Mirza-Asif/AT-PIC/3D Models/Array Holders/README.txt

This document logs changes made to 3D models. 
As a general rule of thumb, a new revision marks a new function or major geometric change to the design.
Sub-revisions (ex. REV1-2 vs REV1-3) are minor changes usually made for quality of life purposes or minor alterations like 3D printing tolerence adjustments.
A revision or sub-revision marked with *** means that it has not been tested yet. 
- B

REV1&2:
	Description:
		Non-funcitonal placeholders for demonstration
	Flaws:
		Just all of it.

REV3: 
	Description:
		A fiber holder based off of the one used on the MLP testbench.
	Flaws:
		Screw holes were too small and mirza wanted some alterations to the dimentions
REV4:
	Description:
		New adjusted model with more screw holes and changed dimentions. 
		Full set printed.
