Mirza-Asif/AT-PIC/3D Models/Foam Holders/README.txt

These guys are just little connecters to snap onto insulating foam so that you can tape it to a wall. 
Are they overengineered? yes.
Do they double as fun little fidget toys to have around the latb? Also yes.
- B

REV1: 
	Description:
		Initial design with a spinning top.
	Flaws:
		Way to big and takes FOREVER to print.
REV2: 
	Description:
		Made it a bit smaller. Also refined the locking mechanism.
	Flaws:
		These things break just while assembling them.
REV3:
	Description:
		Reinforced the weak parts and made them taller to better fit the foam thinkness.
	Flaws:
		Not nearly as fun to fidget with.
