Mirza-Asif/AT-PIC/3D Models/Z Arm/README.txt

These guys are just little connecters to snap onto insulating foam so that you can tape it to a wall. 
Are they overengineered? yes.
Do they double as fun little fidget toys to have around the latb? Also yes.
- B

REV1: 
	Description:
		So stupid I didnt even bother saving it.
	Flaws:
		Yes.
REV2: 
	Description:
		Fixed and tuned most of the issues. Its largely just the Z axis arm but with a vertical mount.
	Flaws: 
		Not really a flaw in the design, but this thing just wont print wihtout warping >:(
