Mirza-Asif/AT-PIC/Documentation/Senior Design Documents/Year 1 (2023-2024)/Semester 2 Timeline (Rev 3).xlsx

Sheet: GanttChart
AT-PIC Semester 2 - Timeline
 | Project Start Date: |  | 2024-01-15 |  |  |  | Week 0 |  |  |  |  |  |  | Week 1 |  |  |  |  |  |  | Week 2 |  |  |  |  |  |  | Week 3 |  |  |  |  |  |  | Week 4 |  |  |  |  |  |  | Week 5 |  |  |  |  |  |  | Week 6 |  |  |  |  |  |  | Week 7
 | Project Manager: |  | Mahdi Nikdast |  |  |  | 2024-01-08 |  |  |  |  |  |  | 2024-01-15 |  |  |  |  |  |  | 2024-01-22 |  |  |  |  |  |  | 2024-01-29 |  |  |  |  |  |  | 2024-02-05 |  |  |  |  |  |  | 2024-02-12 |  |  |  |  |  |  | 2024-02-19 |  |  |  |  |  |  | 2024-02-26
 |  |  |  |  |  |  | 2024-01-08 | 2024-01-09 | 2024-01-10 | 2024-01-11 | 2024-01-12 | 2024-01-13 | 2024-01-14 | 2024-01-15 | 2024-01-16 | 2024-01-17 | 2024-01-18 | 2024-01-19 | 2024-01-20 | 2024-01-21 | 2024-01-22 | 2024-01-23 | 2024-01-24 | 2024-01-25 | 2024-01-26 | 2024-01-27 | 2024-01-28 | 2024-01-29 | 2024-01-30 | 2024-01-31 | 2024-02-01 | 2024-02-02 | 2024-02-03 | 2024-02-04 | 2024-02-05 | 2024-02-06 | 2024-02-07 | 2024-02-08 | 2024-02-09 | 2024-02-10 | 2024-02-11 | 2024-02-12 | 2024-02-13 | 2024-02-14 | 2024-02-15 | 2024-02-16 | 2024-02-17 | 2024-02-18 | 2024-02-19 | 2024-02-20 | 2024-02-21 | 2024-02-22 | 2024-02-23 | 2024-02-24 | 2024-02-25 | 2024-02-26 | 2024-02-27 | 2024-02-28
WBS | Task | Task | Start | End | % Done | Work Days | M | T | W | Th | F | Sa | Su | M | T | W | Th | F | Sa | Su | M | T | W | Th | F | Sa | Su | M | T | W | Th | F | Sa | Su | M | T | W | Th | F | Sa | Su | M | T | W | Th | F | Sa | Su | M | T | W | Th | F | Sa | Su | M | T | W
1 | [ Task Category ] | [Name] | 2024-01-16 | 2024-05-06 | 100% | 80
1.1 | Ali | Learn LabVIEW | 2024-01-18 | 2024-02-18 | 100% | 22
1.2 | Gavin | Power Supply Setup for Aerotech | 2024-01-18 | 2024-02-27 | 100% | 29
1.3 | Trent | Interface With Newport Controllers | 2024-01-24 | 2024-02-28 | 95% | 26
1.4 | Ben | Design Hexapod Arm | 2024-02-12 | 2024-02-25 | 100% | 10
1.5 | Ben | Manufacture Hexapod Arm | 2024-02-25 | 2024-03-02 | 100% | 5
1.6 | Gavin | Power System Setup for SMCI | 2024-02-27 | 2024-03-12 | 100% | 11
1.7 | Ali | Interface with controllers using labview | 2024-03-01 | 2024-04-01 | 50% | 22
1.9 | Ben | Design Z axis Arm | 2024-03-04 | 2024-03-11 | 100% | 7
1.9 | Ben | Manufacture Z axis Arm | 2024-03-11 | 2024-03-15 | 100% | 7
1.10 | Ben | Design Base for Mounting | 2024-03-11 | 2024-03-26 | 100% | 12
1.11 | Ben | Manufacture Base for Mounting | 2024-03-20 | 2024-03-30 | 100% | 8
1.12 | Trent | Automating Hexapod | 2024-03-26 | 2024-04-04 | 50% | 8
1.13 | Gavin | Mounting/Wiring | 2024-03-26 | 2024-04-04 | 100% | 8
1.14 | All | All Physical Components Done | 2024-04-04 | 2024-04-12 | 100% | 7

Sheet: Help
Help |  | © 2012-2018 Vertex42 LLC
 |  | Contact Vertex42 (https://www.vertex42.com/about.html)
Introduction
 | This Gantt Chart spreadsheet makes creating a project schedule very easy. You only need to know some basic spreadsheet operations to make this gantt chart work for you, such as how to insert, delete, copy and paste entire rows.
 | Be sure to read the Getting Started Tips below.
 | The Share settings for this spreadsheet must always be set to "Private"
 | See the TermsOfUse worksheet for more information about how you may or may not share this template.
Getting Started Tips
- | Input cells for defining the task dates and durations have a light green background. | Input Cell
- | [ Bracketed Text ] is also meant to be edited, like the project title and task descriptions.
- | Some of the labels include cell notes to provide extra help information. | Label
- | The Project Start Date determines the first week shown in the gantt chart.
- | To adjust the range of dates shown in the gantt chart, change the Display Week.
- | The red line in the gantt chart represents the date in the Today's Date cell. You can enter Today's Date manually or use the formula =TODAY()
- | To insert a new task, insert a new row, then copy/paste an existing row from the selection of Template Rows at the bottom of the worksheet.
- | Edit the Holidays worksheet to choose which dates you want to exclude from Work Days.
Cell Color Key
 | Input Cell :: Indicates which set of inputs to use
 | Completed Task :: In the Gantt chart, indicates the completed portion of the task
 | Incomplete Task :: In the Gantt chart, indicates the incomplete portion of the task
Using the Template Rows and Choosing a WBS Level
 | Inserting New Tasks
 | 1. Insert a new blank row where you want the new task to be
 | 2. Copy the entire row you want to use from the set of template rows
 | 3. Paste the row you copied on top of the blank row you just inserted
 | 4. Copy and paste the WBS cell separately, based on the level (1, 2.1, 3.2.1, 4.3.2.1)
 | - When inserting new rows, you must copy and paste an entire row, because the cells of the Gantt chart area are formulas.
 | Changing the WBS Level in the WBS Column
 | - The WBS numbering uses a different formula for each level, but the formula does not reference any other cell in the row. So, you can copy and paste just the WBS cell that you want to use.
 | - If you leave a blank cell above a WBS number, the numbering will reset to 1.x.x. The formulas are meant for convenience, but you can manually enter them if you need to.
 | - You can indent the task description for sub-tasks by entering spaces (until Google decides to add an indent option).
 | Category Tasks
 | - You can use tasks that are just labels, but it can be even more useful for a category task to display the minimum Start date and maximum End date of its sub tasks. This can be done using =MIN(range_of_startdates) and =MAX(range_of_enddates). An example template row is provided, but you will need to update the MIN() and MAX() formulas.
Creating Task Dependencies
 | - You can enter the Start date manually, or define task dependecies using a formula. Below are the most common options for defining the Start date:
A. | Enter the date manually (e.g. 1/3/2015)
B. | Reference the Project Start Date (e.g. =$E$4 )
C. | Set the Start date to the next Work Day after another task's End date.
 | - Use the formula =WORKDAY(enddate,1) where enddate is the reference to the End date of a predecessor task.
 | - For multiple predecessors, the formula would be =MAX(WORKDAY(enddate1,1),WORKDAY(enddate2,1))
D. | Set the Start date to the next Calendar Day after another task's End date.
 | - This formula is very simple: =enddate+1
 | - For multiple predecessors, the formula would be =MAX(enddate1,enddate2,enddate3 )+1
E. | Set the Start date to a number of days before or after another date.
 | - This formula is just like the one in C or D, except that in place of the "1" you enter the number of days, such as =WORKDAY(enddate,5) or =WORKDAY(startdate,-5)
FAQs
Q: | What is the best way to Print?
A: | First, select all of the rows you want to print. Then, in the Print Settings, choose "Selection" and check "No Gridlines". Fit to width and print in landscape.
 | You also may want to hide the Days Done, Days Left, and Color columns prior to printing.
Q: | How do I only show Monday-Friday in the chart area?
A: | You can hide the columns that show the weekends.
Q: | How do I print the entire range of dates for my project?
A: | You would first need to add more columns to the displayed chart area. You can insert more columns to the right of the chart area and then copy and paste columns (7 at a time) to extend the display.
 | Note: The more columns you add to the right of the Gantt chart, the slower the recalculation speed will be, because of the number of additional formulas.
Q: | How do I calculate the %Complete for a Summary task?
A: | The %Complete for a summary task can be calculated from its sub tasks using the formula below, where "workdays" is a reference to the range of work days and "complete" is a reference to the %complete for each of the subtasks.
 | =ARRAYFORMULA( SUMPRODUCT( workdays, complete ) / SUM ( workdays ) )
Q: | The Start date, End date, or %Complete for a Level 1 task is wrong. How do I fix it?
A: | When using =MIN(), =MAX(), and =SUMPRODUCT(), it is easy for the references to get messed up if you move rows around or insert new rows. You should verify and fix these formulas if they are not referencing the correct ranges.
Q: | I've messed up the chart area somehow. How do I fix it?
A: | Find a row that works, then copy the cells that make up the gantt chart area from that row into the cells that are messed up.

Sheet: GanttChartPro
Gantt Chart Template Pro for Google Sheets
 | Gantt Chart Template Pro, by Vertex42.com, is a spreadsheet template designed originally for Microsoft Excel that offers more features than the free version. When you purchase it, you will also get a link to download the Pro version for Google Sheets!!
 | Learn More About Gantt Chart Template Pro (https://www.vertex42.com/ExcelTemplates/gantt-chart-template-pro.html)
 | - Visit the web page above to view screenshots and watch demo videos
Features in the Pro version for Google Sheets
 | Define task durations by specifying the number of Work Days
 | - In this free version, the inputs to define a task are the Start Date and the Calendar Day duration. In the Pro version, the default option is to enter the Start Date and the number of Work Days.
 | Choose whether to define task durations using Calendar Days or Work Days or End Dates
 | - The Pro version includes a larger set of template rows that provide more options for defining the Start date, End date, duration, and dependency of tasks.
 | Exclude holidays from work days
 | - List holidays and other non-working days in a separate sheet. When defining task durations using Work Days, these dates will be excluded.
 | Define what you mean by "Weekend" when using Work Days
 | - The Pro version allows you to define exactly which day(s) of the week you want to use as your weekend. The default is Saturday and Sunday.
 | Color-Code bars in the Gantt chart
 | - The Pro version includes a column for entering a color code like "k", "r", or "y" to change the color of the bars in the Gantt chart. The Help worksheet explains some advanced formulas that you could use in the Color column to automatically color a bar based on the name in the Lead column.
 | Define tasks dependences by specifying the predecessor WBS
 | - The template rows include an option for entering a Predecessor WBS. The Start date will be calculated as the day following the End date of the predecessor.

Sheet: TermsOfUse
Terms of Use
Gantt Chart Template for Google Sheets (https://www.vertex42.com/ExcelTemplates/excel-gantt-chart.html)
© 2012-2018 Vertex42 LLC. All rights reserved.
This template is a copyrighted work under the Unites States and other copyright laws and is the property of Vertex42 LLC. The items listed below are additional points to help clarify how you may use this template.
You may make archival copies and customize this template only for your personal use or use within your company or organization and not for resale or public sharing.
You may not remove or alter any logo, trademark, copyright, disclaimer, brand, terms of use, attribution, or other proprietary notices or marks within this template.
This template and any customized or modified version of this template may NOT be sold, distributed, published to an online gallery, hosted on a website, or placed on a public server.
The Share Settings for this spreadsheet must always be set to "Private"
Limited Private Sharing and Other Allowed Uses
See the complete license agreement to learn more about how you may or may not use this template.
View the Complete License Agreement
https://www.vertex42.com/licensing/EULA_privateuse.html
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
