Mirza-Asif/AT-PIC/Documentation/Senior Design Documents/Year 1 (2023-2024)/Budget.xlsx

Sheet: Estimated
Senior design team: | Automated Testing for Photonic Integrated Chips
Code word: | Photonics
Note: This is estimated budget that Team is projecting for the year. It will help teams plan when funds are needed
Estimated date when needed | Explain what component; include link, if needed | Price per unit | Quantity | s/h | Total | Lead time (may help planning)
2023-11-06 | 12x 12mm screws for optics table. | $10.10 | 1 |  | $10.10 | 2 days
2023-10-06 | Cross over ethernet cables | $10.00 | 1 |  | $10.00 | 7 days | NOTE: Almost all of our hardware was donated before the beginning of the project. If our budget looks sparse, this is why.
2023-11-12 | USB-FlyWire | $3.00 | 8 |  | $24.00 | 14 days
2023-11-12 | RS232-USB | $2.00 | 6 |  | $12.00 | 12 days
2023-11-12 | USB-Wifi Adapter | $4.00 | 1 |  | $4.00 | 14 days
2023-01-20 | M6 Screws | $10.00 | 1 |  | $10.00 | 14 days
2023-11-06 | PS2-USB | $5.00 | 1 |  | $5.00 | 14 days
2024-01-24 | 20 AWG Wire | $22.00 | 1 |  | $22.00 | 7 days
2024-01-24 | Ferrite cores | $1.21 | 6 |  | $7.26 | 14 days
2024-01-24 | PCB Plug Screw | $3.68 | 10 |  | $36.80 | 14 days
 |  |  |  | TOTAL | $141.16

Sheet: Actual
Senior design team: | Automated Testing for Photonic Integrated Chips
Code word: | Photonics
Note: Teams may make necessary adjustments for the actual funds that are used to reimburse them out of
Date of purchase | Amount | Explain what component; include link and explanation, if needed | Out of which fund
 |  |  | Professor/Lab | ECE Sr.Des. Fund | Personal | Other#1 | Other#2
2023-10-01 | $40 | Labelmaker | x |  |  |  |  | NOTE: Almost all of our hardware was donated before the beginning of the project. If our budget looks sparse, this is why.
2023-10-01 | $5 | Velcro Cable Ties | x
2023-10-01 | $15 | Screw Driver Set | x
2024-11-06 | $15 | Metric Screw Kit | x
2024-11-12 | $20 | RS232 adapters | x
