Mirza-Asif/AT-PIC/Documentation/HPE Donation List.xlsx

Category | Sub - Category | Qnty | Value | Equipment Description | Manufacture | Model
Electronics | ESA | 1 | $5000.00 | Spectrum Analyzer | Hewlett Pscksrd | E4407B
Electronics | Meter | 2 | $800.00 | Multimeter | HP | 34401A
Electronics | Power Supply | 2 | $700.00 | Power Supply - Programable | Sorinson | DLM 60-10
Electronics | Power Supply | 1 | $3000.00 | Power Supply - Programable | Sorinson | DLM16-185E 502
Electronics | Power Supply | 2 | $1200.00 | Power Supply - Programable | Sorinson | DCS40-25E
Mechanics | Motion | 1 | $20000.00 | Hexapod | Newport | HXP 100P - MECA
Mechanics | Motion | 2 | $1500.00 | Linear motor translation stage | Nanosystec | Nanomove 100/2019/025
Mechanics | Motion | 1 | $1000.00 | Linear motor translation stage | Nanosystec | Nanomove 50/2015/027
Mechanics | Motion | 1 | $300.00 | Manual translation stage XZ | Newport | M - 460A
Mechanics | Motion | 6 | $1000.00 | Motion Controller | Aerotech | A3200 Ndrive MP
Mechanics | Motion | 3 | $200.00 | Motion Controller | Nanotec | SMC133-2
Mechanics | Motion | 1 | $1000.00 | Motion Controller | Aerotech | A3200 Ndrive CP
Mechanics | Motion | 3 | $1000.00 | Motion Controller | Newport | SMC100
Mechanics | Motion | 1 | $500.00 | Motion Controller | Newport | Conex - CC
Mechanics | Motion | 2 | $2500.00 | Motorized ball screw stage | Nanosystec | Slimline Plus 180-280-106 / 2016
Mechanics | Motion | 2 | $750.00 | Motorized ball screw stage | Nanosystec | Slimline Plus 110-50 / 027
Mechanics | Motion | 2 | $1000.00 | Motorized Goniometer stage | Huber | 5203.10-419
Mechanics | Motion | 1 | $500.00 | Motorized Goniometer stage | Newport | BGS50CC
Mechanics | Motion | 2 | $1000.00 | Motorized lead screw translation stages | Newport | VP - 25XA
Mechanics | Motion | 1 | $1500.00 | Motorized rotary stage | Newport | URS150BCC
Mechanics | Motion | 1 | $1500.00 | Motorized rotary stage | Newport | URS100BPP
Mechanics | Motion | 1 | $1000.00 | Motorized Rotary Stage | Newport | PR50PP
Mechanics | Pneumatic | 4 | $250.00 | Pressure Transmitter | Festo | SPTW - P10R - G14 - VD - M12
Mechanics | Pneumatic | 1 | $500.00 | 11 position controller | Festo | CPV - SC - MP - V1
Mechanics | Pneumatic | 1 | $200.00 | Gripper | Robohand | RPL - 1M
Mechanics | Pneumatic | 2 | $500.00 | Linear stage | Festo | SLF - 6-10 - P - A
Mechanics | Pneumatic | 3 | $500.00 | Linear stage | Festo | SLT - 10-10 - P - A
Mechanics | | Pneumatic | 1 | $700.00 | Linear stage | Festo | SLF - 6-30 - P - A
Mechanics | Pneumatic | 1 | $1500.00 | | Pneumatic linear actuator / rotator | Festo | DSL - 16-40-270 - CC - A - S2 - B
Mechanics | Pneumatic | 2 | $200.00 | Regulator | Festo | LRP - 1 / 4-10
Mechanics | Pneumatic | 1 | $100.00 | Regulator | Festo | MS4 - LFR - 1 / 4 - D6 - E - R - M - AS
Mechanics | Pneumatic | 57 | $100.00 | Regulator | Festo | LRB - D - 7 - MINI
Mechanics | Pneumatic | 7 | $100.00 | Switch | Festo | M L802
Mechanics | Pneumatic | 4 | $100.00 | Switch | Festo | S K702
Optics | Camera | 1 | $300.00 | Camera and Lens system | Baslar | acA2500-14gm
Optics | Camera | 1 | $500.00 | Microscopr Camera | Motic | Moticam 580
Optics | Detector | 1 | $200.00 | Photodiode Amplifier | Thorlabs | PDA200C
Optics | Fiber Optics | 10 | $50.00 | Fiber optic one click cleaners | IBC | SC
Optics | Fiber Optics | 1 | $150.00 | Fiber Optic variable attenuator | Thorlabs | VOA50 - APC
Optics | Fiber Optics | 14 | $50.00 | Misc single patch cables | Thorlabs | P5-980A - PCAPC - 1 , P3-980A - FC - 1 , P1-980 - FC - 1
Optics | Metrology | 1 | $100000.00 | 3D Optical Surface Profiler | Zygo | Nexview 6308-0100-11
Optics | Microscope | 1 | $900.00 | Binocular Scope | Olympus | SZ6045
Optics | Table | 1 | $600.00 | Air Compressor | Newport
Optics | Table | 1 | $5000.00 | Optical table | Thorlabs | Nexus , T48V , TF1225A7
Safety | Safety | 1 | $500.00 | Germicidal Cabinet | Sellstrom
Safety | Safety | 10 | $40.00 | Laser Safety Glasses | Noir | DD1
Mechanics | Pneumatic | 1 | $1000.00 | Translation stage manual XZ | Newport | M460A
