Mirza-Asif/AT-PIC/3D Models/Array Holders/REV4/array_holder_8_REV4.SLDPRT

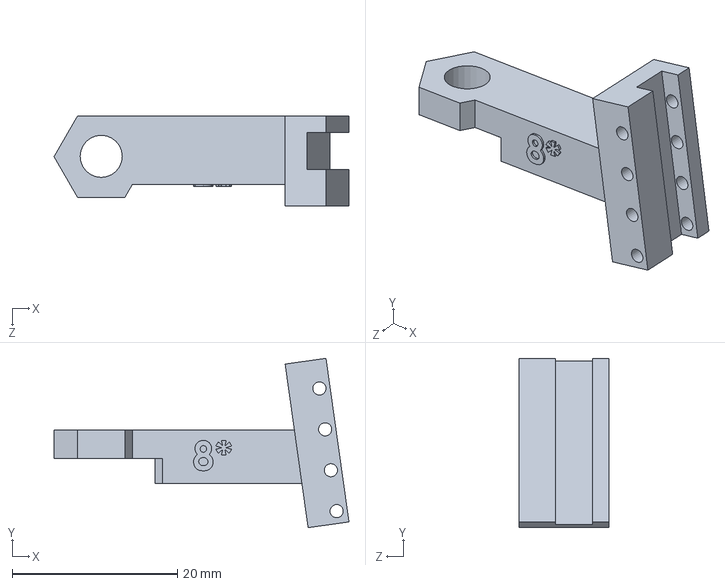
[picture p24: CAD file, 2024-05-06]
3D Models/Array Holders/REV4/array_holder_8_REV4.SLDPRT
35.7 x 20.5 x 11.0 mm
