Mirza-Asif/AT-PIC/3D Models/Chip Stage/REV4/SLDPRT/stage_REV4.SLDPRT

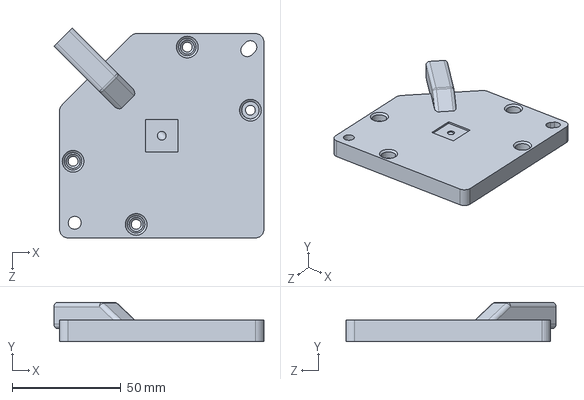
[picture p25: CAD file, 2024-05-06]
3D Models/Chip Stage/REV4/SLDPRT/stage_REV4.SLDPRT
96.5 x 18.0 x 96.5 mm
