Mirza-Asif/AT-PIC/3D Models/Converter Blocks/REV1/SLDPRT/hex_top_blocks_REV1.SLDPRT

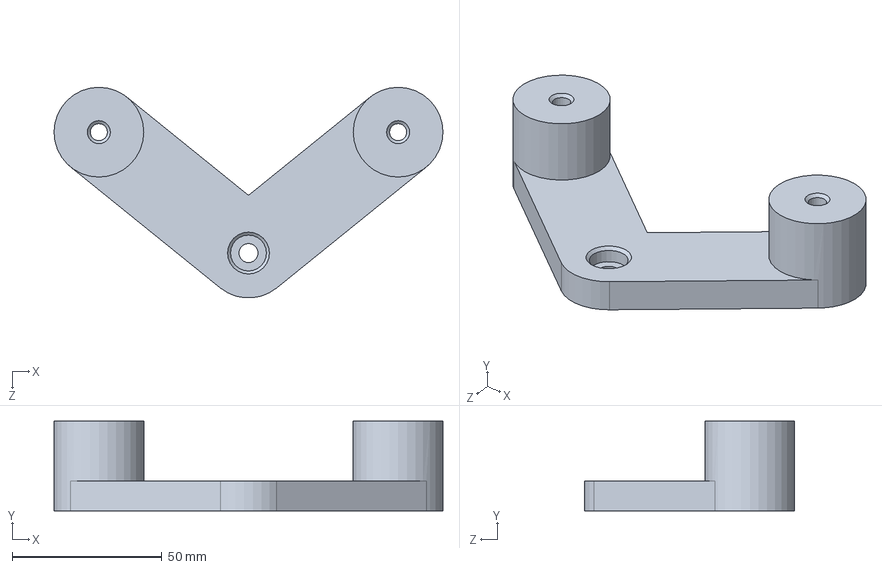
[picture p26: CAD file, 2024-05-06]
3D Models/Converter Blocks/REV1/SLDPRT/hex_top_blocks_REV1.SLDPRT
130.0 x 30.0 x 70.3 mm
