Mirza-Asif/AT-PIC/3D Models/Foam Holders/REV3/SLDPRT/Lock_REV3.SLDPRT

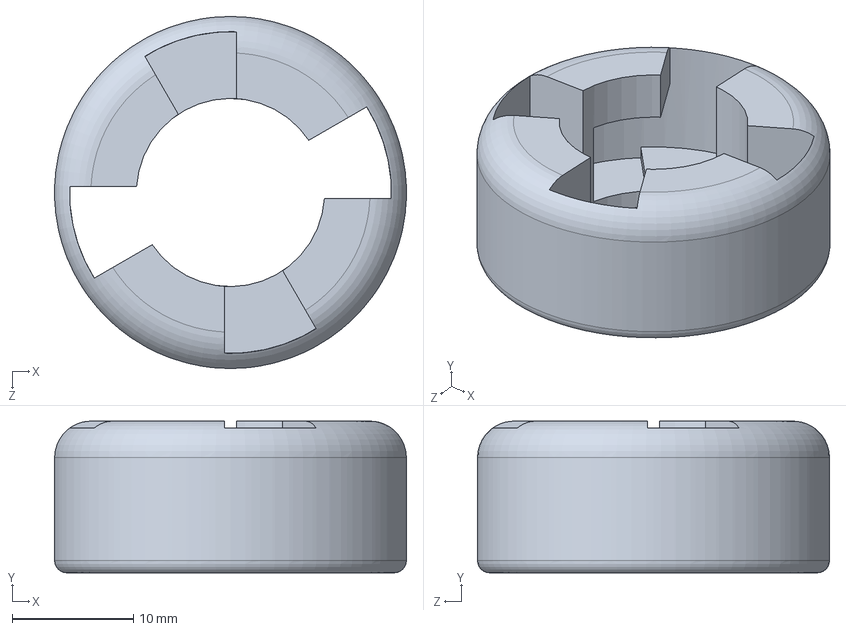
[picture p27: CAD file, 2024-05-06]
3D Models/Foam Holders/REV3/SLDPRT/Lock_REV3.SLDPRT
29.0 x 12.5 x 29.0 mm
