Mirza-Asif/AT-PIC/3D Models/Hex Arm/REV2-1/SLDPRT/Fiberholder02-Body.SLDPRT

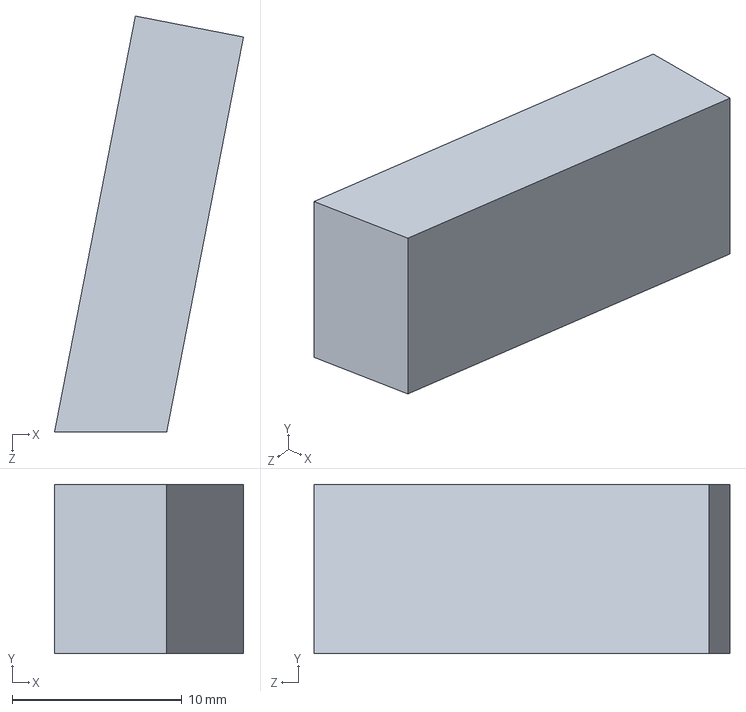
[picture p28: CAD file, 2024-05-06]
3D Models/Hex Arm/REV2-1/SLDPRT/Fiberholder02-Body.SLDPRT
11.2 x 10.0 x 24.5 mm
