Mirza-Asif/AT-PIC/3D Models/Hex Arm/REV3/SLDPRT/hex_arm_base_REV3.SLDPRT

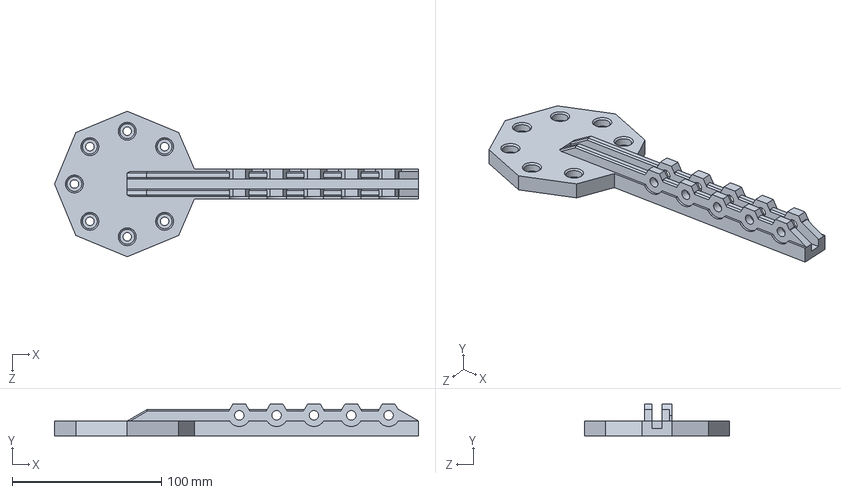
[picture p29: CAD file, 2024-05-06]
3D Models/Hex Arm/REV3/SLDPRT/hex_arm_base_REV3.SLDPRT
243.7 x 21.2 x 97.4 mm
