Mirza-Asif/AT-PIC/3D Models/Z Arm/REV2-1/SLDPRT/extender_arm_REV2-1.SLDPRT

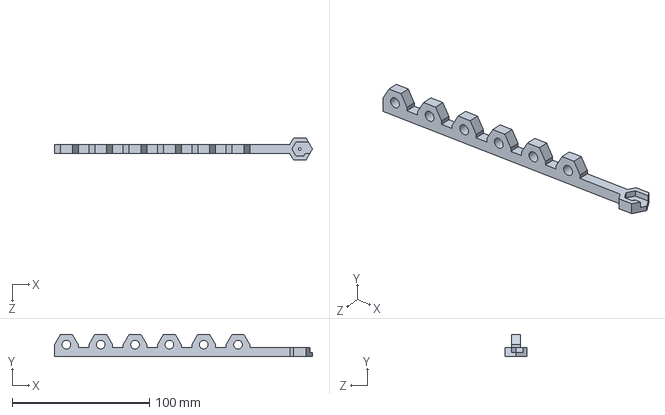
[picture p30: CAD file, 2024-05-06]
3D Models/Z Arm/REV2-1/SLDPRT/extender_arm_REV2-1.SLDPRT
187.9 x 16.2 x 16.0 mm
