Mirza-Asif/AT-PIC/3D Models/Z Arm/REV2-2/SLDPRT/array_holder_REV2-1.SLDPRT

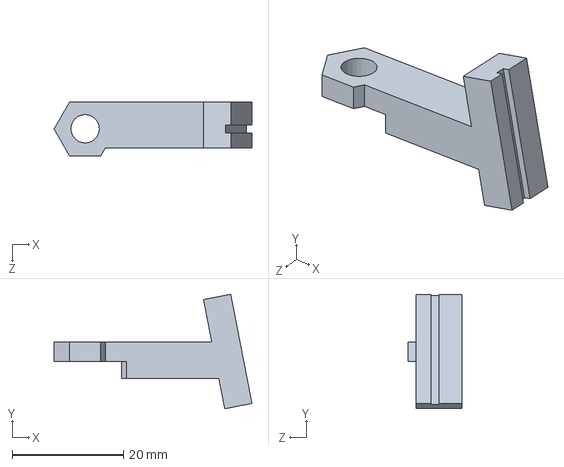
[picture p31: CAD file, 2024-05-06]
3D Models/Z Arm/REV2-2/SLDPRT/array_holder_REV2-1.SLDPRT
35.6 x 20.6 x 9.70 mm
