Mirza-Asif/AT-PIC/3D Models/Converter Blocks/REV1/SLDPRT/hex_side_blocks_REV1.SLDPRT

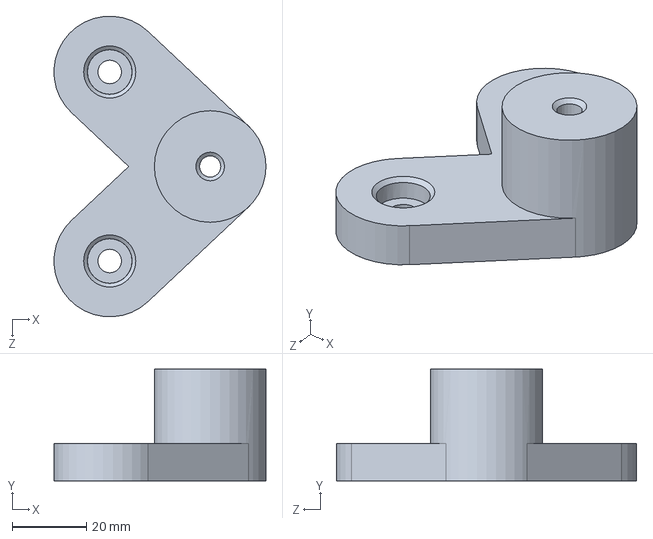
[picture p32: CAD file, 2024-05-06]
3D Models/Converter Blocks/REV1/SLDPRT/hex_side_blocks_REV1.SLDPRT
57.0 x 30.0 x 80.8 mm
