Mirza-Asif/AT-PIC/3D Models/Foam Holders/REV3/SLDPRT/Base_REV3.SLDPRT

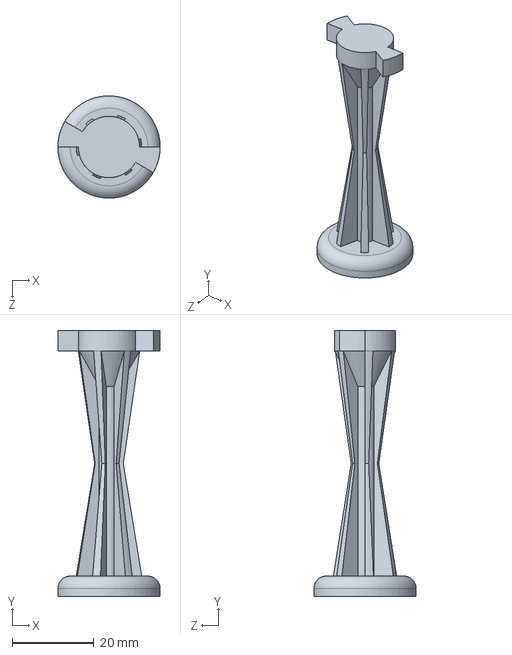
[picture p33: CAD file, 2024-05-06]
3D Models/Foam Holders/REV3/SLDPRT/Base_REV3.SLDPRT
25.0 x 65.0 x 25.0 mm
