Mirza-Asif/AT-PIC/3D Models/Hex Arm/REV2-1/SLDPRT/hex_arm_base_REV2-1.SLDPRT

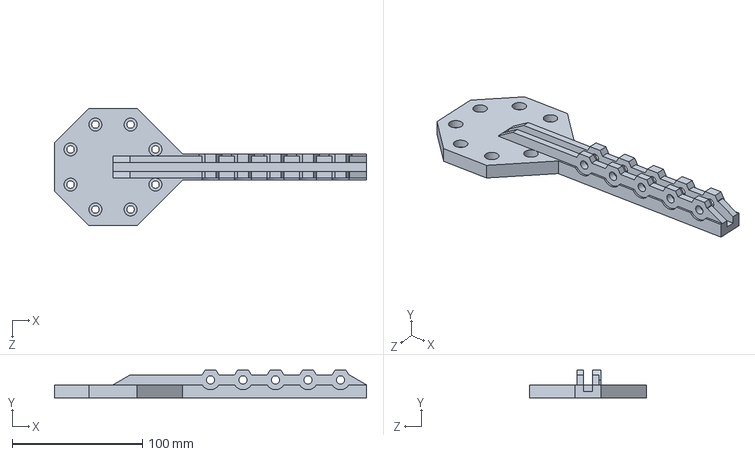
[picture p34: CAD file, 2024-05-06]
3D Models/Hex Arm/REV2-1/SLDPRT/hex_arm_base_REV2-1.SLDPRT
240.0 x 21.2 x 90.0 mm
