Mirza-Asif/AT-PIC/3D Models/Z Arm/REV2-1/SLDPRT/Z_arm_base_REV2-1.SLDPRT

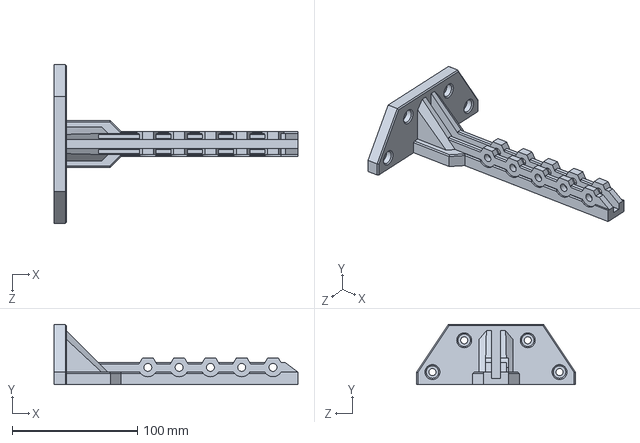
[picture p35: CAD file, 2024-05-06]
3D Models/Z Arm/REV2-1/SLDPRT/Z_arm_base_REV2-1.SLDPRT
195.0 x 48.1 x 127.0 mm
