Mirza-Asif/AT-PIC/(list of files, cad)

Other CAD files:
3D Models/Array Holders/REV4/array_holder_10_REV4.SLDPRT
3D Models/Z Arm/REV2-2/SLDPRT/Z_arm_base_REV2-2.SLDPRT
3D Models/Array Holders/REV4/array_holder_14_REV4.SLDPRT
3D Models/Hex Arm/REV3/SLDPRT/array_holder_REV2-1.SLDPRT
3D Models/Array Holders/REV4/array_holder_15_REV4.SLDPRT
3D Models/Array Holders/REV4/array_holder_9_REV4.SLDPRT
3D Models/Array Holders/REV4/array_holder_12_REV4.SLDPRT
3D Models/Array Holders/REV4/array_holder_7_REV4.SLDPRT
3D Models/Array Holders/REV4/array_holder_11_REV4.SLDPRT
3D Models/Array Holders/REV4/array_holder_13_REV4.SLDPRT
3D Models/Array Holders/REV3/SLDPRT/array_holder_11_REV3.SLDPRT
3D Models/Array Holders/REV3/SLDPRT/array_holder_REV3.SLDPRT
3D Models/Array Holders/REV3/STL/array_holder_11_REV3.STL
3D Models/Array Holders/REV4/STL/array_holder_10_REV4.STL
3D Models/Array Holders/REV4/STL/array_holder_11_REV4.STL
3D Models/Array Holders/REV4/STL/array_holder_12_REV4.STL
3D Models/Array Holders/REV4/STL/array_holder_13_REV4.STL
3D Models/Array Holders/REV4/STL/array_holder_14_REV4.STL
3D Models/Array Holders/REV4/STL/array_holder_15_REV4.STL
3D Models/Array Holders/REV4/STL/array_holder_6_REV4.STL
3D Models/Array Holders/REV4/STL/array_holder_7_REV4.STL
3D Models/Array Holders/REV4/STL/array_holder_8_REV4.STL
3D Models/Array Holders/REV4/STL/array_holder_9_REV4.STL
3D Models/Chip Stage/REV1/SLDPRT/stage_REV1.SLDPRT
3D Models/Chip Stage/REV1/STL/stage_REV1.STL
3D Models/Chip Stage/REV2/SLDPRT/stage_REV2.SLDPRT
3D Models/Chip Stage/REV2/STL/stage_REV2.STL
3D Models/Chip Stage/REV2/gcode/stage_REV2.3mf
3D Models/Chip Stage/REV3/SLDPRT/stage_REV3.SLDPRT
3D Models/Chip Stage/REV3/STL/stage_REV3.STL
3D Models/Chip Stage/REV4/STL/stage_REV4.STL
3D Models/Converter Blocks/REV1/STL/hex_side_blocks_REV1.STL
3D Models/Converter Blocks/REV1/STL/hex_top_blocks_REV1.STL
3D Models/Foam Holders/REV1/SLDPRT/Base.SLDPRT
3D Models/Foam Holders/REV1/SLDPRT/Lock.SLDPRT
3D Models/Foam Holders/REV1/STL/Base.STL
3D Models/Foam Holders/REV1/STL/Lock.STL
3D Models/Foam Holders/REV2/SLDPRT/Assem1.SLDASM
3D Models/Foam Holders/REV2/SLDPRT/Base_REV2.SLDPRT
3D Models/Foam Holders/REV2/SLDPRT/Lock_REV2.SLDPRT
3D Models/Foam Holders/REV2/STL/Base_REV2.STL
3D Models/Foam Holders/REV2/STL/Lock_REV2.STL
3D Models/Foam Holders/REV3/STL/Base_REV3.STL
3D Models/Foam Holders/REV3/STL/Lock_REV3.STL
3D Models/Hex Arm/REV1/arm_base.STL
3D Models/Hex Arm/REV1/fixed11_arm.STL
3D Models/Hex Arm/REV2-1/STL/array_holder_REV2-1.STL
3D Models/Hex Arm/REV2-1/STL/extender_arm_REV2-1.STL
3D Models/Hex Arm/REV2-1/STL/hex_arm_base_REV2-1.STL
3D Models/Hex Arm/REV2/adjuster_arm_REV2.SLDPRT
3D Models/Hex Arm/REV2/adjuster_arm_REV2.STL
3D Models/Hex Arm/REV2/array_holder_REV2.SLDPRT
3D Models/Hex Arm/REV2/array_holder_REV2.STL
3D Models/Hex Arm/REV2/hex_arm_base_REV2.SLDPRT
3D Models/Hex Arm/REV2/hex_arm_base_REV2.STL
3D Models/Hex Arm/REV3/STL/array_holder_REV2-1.STL
3D Models/Hex Arm/REV3/STL/extender_arm_REV2-1.STL
3D Models/Hex Arm/REV3/STL/hex_arm_base_REV3.STL
3D Models/Z Arm/REV2-1/STL/Z_arm_base_REV2-1.STL
3D Models/Z Arm/REV2-2/STL/Z_arm_base_REV2-2.STL
