Mirza-Asif/AT-PIC/Documentation/Senior Design Documents/Year 1 (2023-2024)/FMEA.xlsx

PROPOSED FMEA TABLE
Process Step | Potential Failure Mode | Potenetial Failure Effect | SEV1 | Potential Causes | OCC2 | Current Process Controls | DET3 | RPN4 | Action Recommended
What is the step? | In what ways can step go wrong? | What is the impact on the customer if the failure mode is not prevented or corrected? | How severe is the effect on the customer? | What causes the step to go wrong (i.e. how could the failure mode occur)? | How frequently is the cause likely to occur? | What are the existing controls that either prevent the failure mode from occuring or detect it should it occur? | How probabale is detection of the failure mode or its cause? | Risk priority number calculated as SEV x OCC x DET | What are the actions for reducting the occurenece of the causes or for improving its detection? Provide actions on high RPNs and on severity ratings of 9 or 10
Software Bugs | Glitches | Incorrect test result | 8 | Insufficient software testing | 4 | Validation processes | 4 | 128 | Improve sotware testing procedures
Assembly | Misalignment of componentss | Potential damage to components | 9 | Lack of precise assembly | 2 | A few spare or alternative parts. | 7 | 126 | Multiple person verifications of hardware and electrical connections. Labeling of electrical power supply lines.
Motor Control Functions | Potential failure of accuracy when moving with chip | Potential damage to components as well not being able to connect the optical fiber | 8 | Improper installation of parts or improper callibration | 2 | Proper installation, Code failsafes | 9 | 144 | Testing the Motor controlls throughougly and creating a validation test.
General Movement Functions | Potential failure of non functioning motors | Non usable testing station | 10 | Improper installation of parts or failure of motor drivers | 1 | Pre testing motors and driver setup before installation | 10 | 100 | By validating the motors functioning properly
Optical Fiber | Threading breaks | Non usable testing station, multiple months for replacemnt part | 10 | Improper use of testing station | 2 | Alternative parts are preordered | 10 | 200 | We could also create a digital limit so that optical fiber could be protected
Vaccum Holder of Chip | Does not properly hold chip | Potential harm to Silicon Chip | 9 | Vaccum tube failure or misalignment | 2 | Tube sealing and clamps | 2 | 36 | Potential testing with soapy water to check for leaks
Camera for Fiber Alignment | Camera does not properly connect to computer | Makes use of testing bench siginifcantly harder | 5 | Incorrect driver installation, loose wiring | 2 | Having a permanent connection so as to decrease likliehood of loose connections | 9 | 90 | Conduct a multiple testing along the way to make sure that does not happen
Calibration Errors | Indequate calibration of testing equipment | potential damage to silicon photonic chip | 10 | Lack of equipment calibration | 3 | Carefully observe the movment of the fiber usign a focused camera | 7 | 210 | Attach a good quality camera to the station setup
1. Severity : Severity of impact of failure event. It is scored on a scale of 1 to 10. A high score is assigned to high-impact events while a low score is assigned to low -impact events
2. Occurrence: Frerqunecy of occurrence of failure event . It is scored on a scale of 1 to 10. A high score is assigned to frequently occuring events while eith low occurrence are assigned a low score
3 . Detection: Ability of process control to detect the occurrence of failure events. It is scored on a scale of 1 to 10. A failure event that can be easily detected by the process control is assigned a low score while a high score is assigned to an inconspicuous event
4. Risk priority number: The overall risk score of an event. It is calculated by multiplying the score for severity, occurrence and detection. An event with a high RPN demands immediate attention while events with lower RPN are less risky
