Mirza-Asif/AT-PIC/Documentation/Senior Design Documents/Year 1 (2023-2024)/Risk.xlsx

Proposed Risk Analysis table
# | Risk Event | Probability/100 | Impact, weeks | Score, hours | Effect | Risk Mitigation Plan | Person responsible for implementing control
 | current testing station fiber damage | 5 | 12 | 60 | Fiber array damage leading to disruption in testing | get a backup
 | unable to access motor driver control software | 15 | 6 | 90 | Delay in project tasks | Find a different motor drivers that can be used
 | Claibration and alignment challenges | 10 | 4 | 40 | Calibration errors leading to inaccurate measurments | Devolpe automated alignment and calibration to reduce human error
 | Enviromental Sensitivity | 20 | 5 | 100 | Enviromental variations affecting test accurecy | Design the testing station with controlled enviromental conditions
 | Equipments Relaibaility | 20 | 4 | 80 | Equipment failure | Contact HP for a replacment or order it online
 | Power outage | 5 | 4 | 20 | Delay and data loss | Regularly test the power
Total risk :
